djubb/zigbee-co2-sensor/main/config.h

#pragma once

#include <stdint.h>
#include "driver/gpio.h"


#define SDC4X_SDA_PIN GPIO_NUM_19  // Aligned with SCD-41 header: GND-3V3-SCL-SDA → GPIO20-GPIO19
#define SDC4X_SCL_PIN GPIO_NUM_20  // Allows direct board-to-board pin header connection
// Recommened measurement interval from sensirion is 5 minutes as the default ASC settings are assuming 5 minutes
#define MEASURE_INTERVAL_MS (60 * 5 * 1000)


// Sanity values for measurement bounds
#define TEMP_MIN -10
#define TEMP_MAX 60

#define HUMID_MIN 0
#define HUMID_MAX 95

#define CO2_MIN 0.0
#define CO2_MAX 5000.0

// Misc settings, for very fine tuning
// time in ms before the zigbee stack sends a CAN_SLEEP signal
#define ZIGBEE_SLEEP_THRESHOLD 20

// Battery voltage sensing (ESP32-C6 SuperMini)
// GPIO1 is connected to battery via 1MΩ/1MΩ voltage divider (B+ → 1MΩ → GPIO1 → 1MΩ → GND)
#include "esp_adc/adc_oneshot.h"
#define BATTERY_ADC_CHANNEL     ADC_CHANNEL_1  // GPIO1
#define BATTERY_ADC_UNIT        ADC_UNIT_1
#define BATTERY_VOLTAGE_DIVIDER 2              // 1MΩ/1MΩ divider ratio
#define BATTERY_FULL_MV         4200           // mV at 100% charge
#define BATTERY_EMPTY_MV        3000           // mV at 0% charge
