djubb/zigbee-co2-sensor/main/zigbee.c

#include "esp_zigbee_core.h"
#include "esp_check.h"
#include "esp_log.h"
#include "string.h"

static const char *TAG = "zigbee";

void reportAttribute(uint8_t endpoint, uint16_t clusterID, uint16_t attributeID, void *value, uint8_t value_length)
{
    esp_zb_zcl_report_attr_cmd_t cmd = {
        .zcl_basic_cmd = {
            .dst_addr_u.addr_short = 0x0000,
            .dst_endpoint = endpoint,
            .src_endpoint = endpoint,
        },
        .address_mode = ESP_ZB_APS_ADDR_MODE_16_ENDP_PRESENT,
        .clusterID = clusterID,
        .attributeID = attributeID,
        .cluster_role = ESP_ZB_ZCL_CLUSTER_SERVER_ROLE,
    };
    esp_zb_zcl_attr_t *value_r = esp_zb_zcl_get_attribute(endpoint, clusterID, ESP_ZB_ZCL_CLUSTER_SERVER_ROLE, attributeID);
    memcpy(value_r->data_p, value, value_length);
    esp_err_t err = esp_zb_zcl_report_attr_cmd_req(&cmd);
    if (err != ESP_OK) {
        ESP_LOGW(TAG, "report_attr cluster=0x%04x attr=0x%04x: %s", clusterID, attributeID, esp_err_to_name(err));
    }
}
