djubb/zigbee-co2-sensor/(commit log)

2026-04-27 add battery
2026-04-28 Fix I2C implicit declaration error; remove esp32h2 from CI matrix
    - Update esp-idf-scd4x submodule with sensirion_i2c_hal_reset_bus()
    - Remove esp32h2 from build matrix to speed up CI
2026-04-28 Inline esp-idf-scd4x, add battery monitoring via Zigbee Power Config cluster
    - Remove git submodule, inline esp-idf-scd4x as regular directory (fixes CI)
    - Add Power Configuration cluster (0x0001) with battery voltage and percentage
    - Change power_source from mains (0x04) to battery (0x03) in Basic cluster
    - Add ADC reading on GPIO1 for LiPo voltage via 100K/100K voltage divider
    - Report battery voltage and percentage to ZHA alongside CO2 measurements
    [zigbee_task.c]
2026-04-28 Fix crash on battery attribute report: replace ESP_ERROR_CHECK with warning log
    The Power Config cluster (0x0001) attributes return ESP_ERR_NOT_SUPPORTED from
    esp_zb_zcl_report_attr_cmd_req until ZHA configures attribute reporting after
    re-pairing. The local attribute value is already written via memcpy, so ZHA can
    poll it. Crashing here is incorrect behavior.
    [zigbee.c]
2026-04-28 Fix I2C hang after light sleep: reinit driver instead of bus reset
    CONFIG_PM_POWER_DOWN_PERIPHERAL_IN_LIGHT_SLEEP powers off the I2C peripheral
    completely during sleep. i2c_master_bus_reset() only sends SCL pulses and is
    not sufficient. Full free+init is required before each measurement cycle.
    Also fix sensirion_i2c_hal_free(): was calling bus_reset instead of
    bus_delete, and leaking allocated memory for handles.
    [co2_task.c, sensirion_i2c_hal.c]
2026-04-28 Fix: use i2c_del_master_bus() instead of non-existent i2c_master_bus_delete()
    [sensirion_i2c_hal.c]
2026-04-28 Keep device awake 60s after first join to allow ZHA interview to complete
    After STEERING success, set commissioning_done_at_us = now + 60s.
    Sleep is blocked until this deadline passes, ensuring ZHA has time to
    complete device interview and configure attribute reporting for all clusters.
2026-04-28 Fix persistent I2C watchdog: disable peripheral power-down during light sleep
    CONFIG_PM_POWER_DOWN_PERIPHERAL_IN_LIGHT_SLEEP=y completely powers off the
    I2C peripheral during light sleep, breaking the interrupt semaphore in
    s_i2c_synchronous_transaction. Neither bus reset nor free+init can recover
    from this state. Disabling peripheral power-down keeps I2C functional.
2026-04-28 Turn off onboard WS2812B LED on startup to save battery
    The ESP32-C6 SuperMini has a WS2812B on GPIO8 that draws ~20mA
    when lit. Initialize it and send black (0,0,0) at boot, then release
    the RMT channel.
2026-04-28 Fix led_strip: add via IDF component manager instead of built-in
    led_strip was moved to IDF component manager in ESP-IDF 5.x.
    Add espressif/led_strip via idf_component.yml dependency.
2026-04-29 Pin led_strip to 2.x — 3.x API removed led_pixel_format field
2026-06-01 add voltage
2026-06-01 change pin
2026-06-02 add support voltage
